GerardWassink/GAW_Measure/gfx/IMG_4089.JPEG

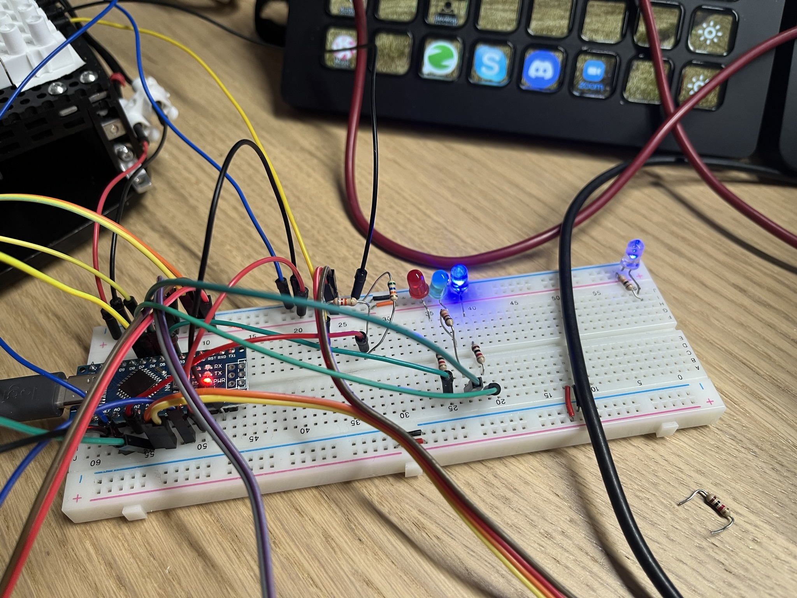
gfx/IMG_4089.JPEG
