GerardWassink/GAW_Measure/gfx/IMG_4090.JPEG

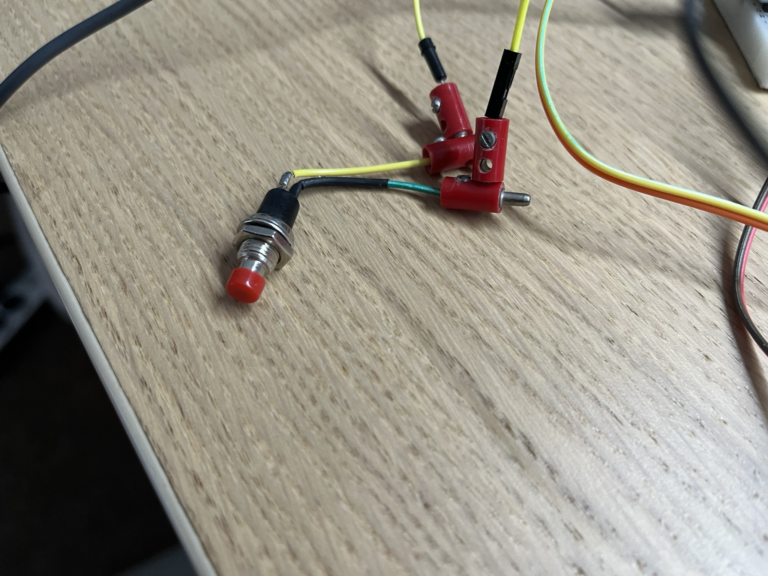
gfx/IMG_4090.JPEG
