GerardWassink/GAW_Measure/PCB/PCB_Design.png

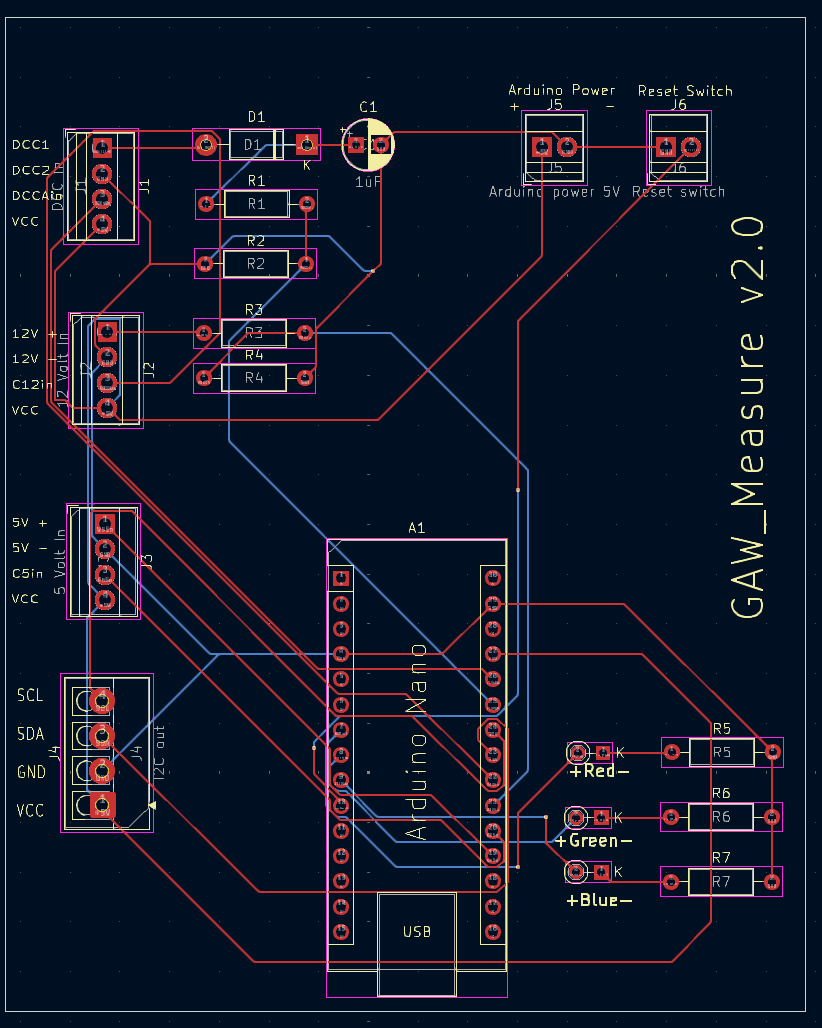
PCB/PCB_Design.png
