GerardWassink/GAW_Measure/PCB/GAW_Measure_2.0_PCB_back.png

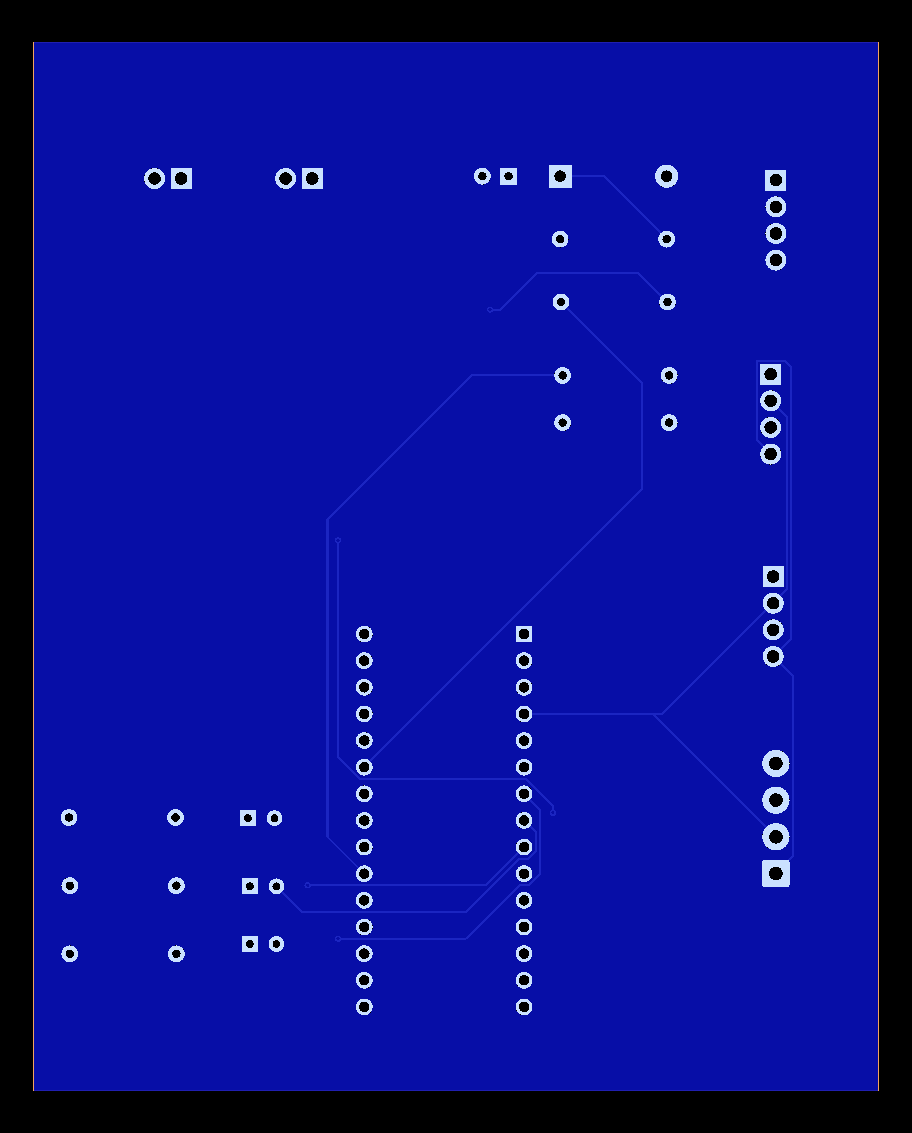
PCB/GAW_Measure_2.0_PCB_back.png
