GerardWassink/GAW_Measure/(commit log)

2025-02-16 Version update
    - update to 1.0
    - debugging switched off
2025-02-17 Version 1.2
    * Solved different readings when connected or not connected to USB
    * by connecting the separate Arduino power supply to the 5V pin
    * Carefull, this may absolutely not be much more than 5 volts!
    [GAW_Measure.ino]
2025-02-20 version 1.4
    * Switched to one display 20x4 instead of 3 displays 16x2
    * Built in over-current detection, signal thru LEDs, reset button
2025-02-20 Over current warning
2025-02-20 Three LEDs
    Indicators for over-current
2025-02-20 Reset switch
2025-02-21 Version 1.5
    * Added DCC voltage
2025-02-23 version 2.0
    * Added schematics and PCB design
    * Release 2.0
2025-02-27 Added PCB masks
2025-03-15 Version 2.2
    * 2.1 : Corrected upper current limit to 2.5 A
    * 2.2 : Corrected for positive AND negative current limits
    [GAW_Measure.ino]
